ArielRobotti/esp32-microsd/sample2.PNG

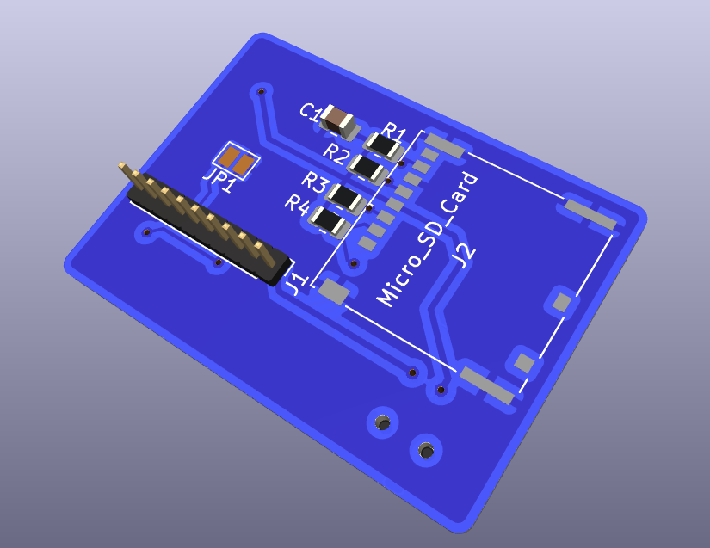
sample2.PNG
