ArielRobotti/esp32-microsd/sample1.PNG

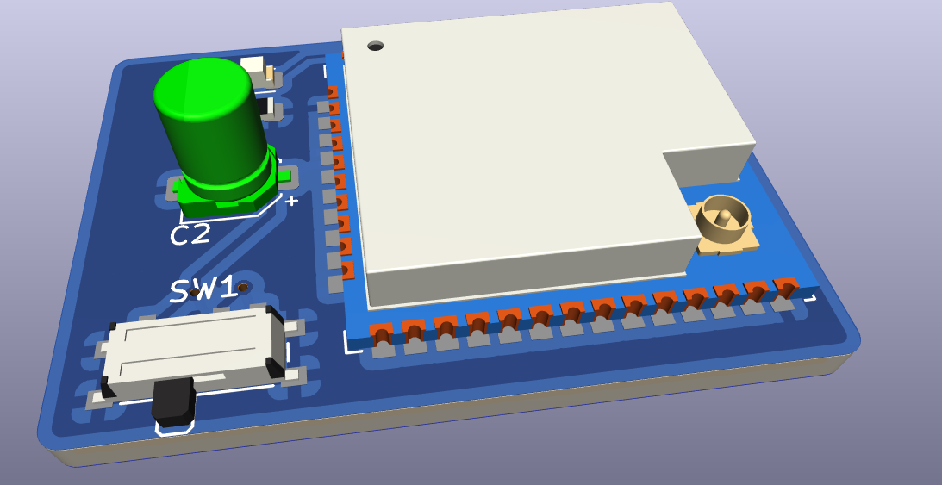
sample1.PNG
