ArielRobotti/esp32-microsd/README.md

# esp32-microsd
Proyecto solicitado por https://es.fiverr.com/drslump
