ArielRobotti/esp32-microsd/CapturaEasyEda.PNG

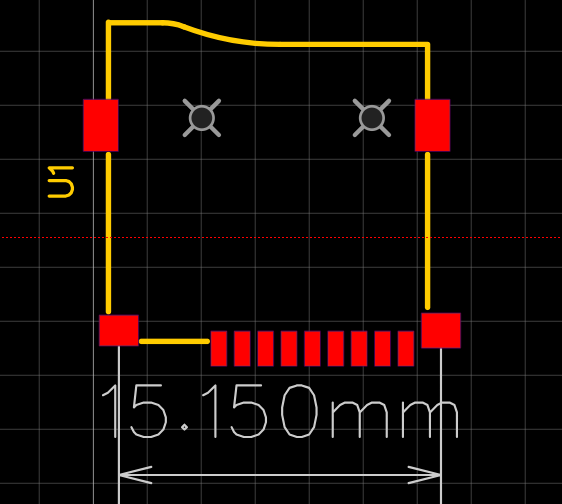
CapturaEasyEda.PNG
