ArielRobotti/esp32-microsd/ESP32_MicroSD/microsd.dxf

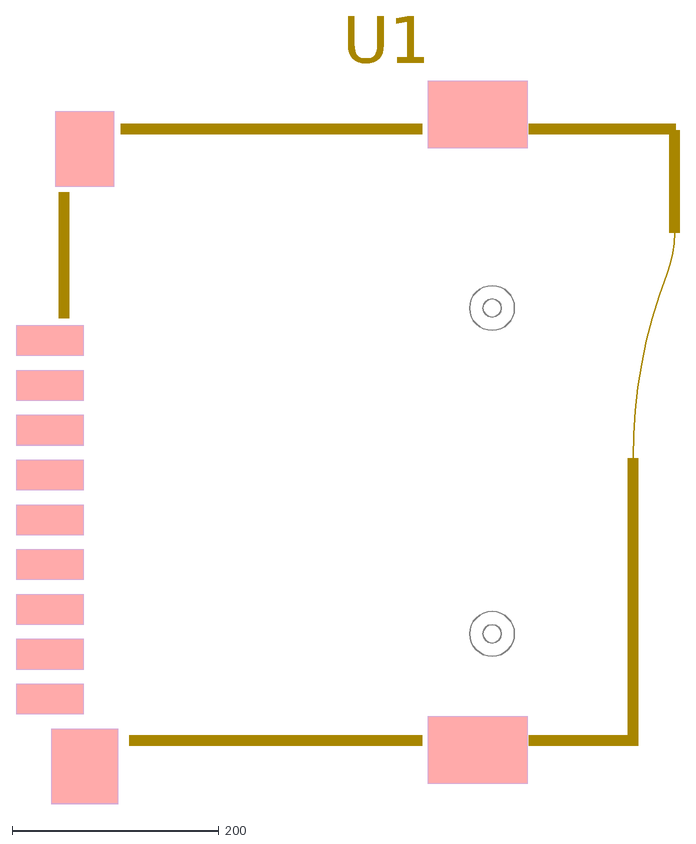
[picture p4: CAD file, 2023-10-07]
ESP32_MicroSD/microsd.dxf
U1
