ArielRobotti/esp32-microsd/(commit log)

2023-02-27 acomodar pinHeader
    [ESP32_MicroSD.kicad_pcb, ESP32_MicroSD.kicad_sch]
2023-03-06 Fix J1
    [ESP32_MicroSD-B_Cu.gbr, ESP32_MicroSD-B_Mask.gbr, ESP32_MicroSD-B_Paste.gbr, ESP32_MicroSD-B_Silkscreen.gbr, ESP32_MicroSD-Edge_Cuts.gbr, ESP32_MicroSD-F_Cu.gbr, ESP32_MicroSD-F_Mask.gbr, ESP32_MicroSD-F_Paste.gbr]
2023-10-07 Cambio de huella mSD
    [ESP32_MicroSD-B_Cu.gbr, ESP32_MicroSD-B_Mask.gbr, ESP32_MicroSD-B_Paste.gbr, ESP32_MicroSD-B_Silkscreen.gbr, ESP32_MicroSD-Edge_Cuts.gbr, ESP32_MicroSD-F_Cu.gbr, ESP32_MicroSD-F_Mask.gbr, ESP32_MicroSD-F_Paste.gbr]
